butaniravi/JRFCQAI/README.md

# 🚀 JRFCQAI: Dual-Brain Physical AI Fight Computer, Flight Controller & Ground Station all Developed on Arduino UNO Q





**Developer:** Ravi Butani  
**Track:** Robotics & Autonomous UAV  
**Board:** Arduino UNO Q (Qualcomm® Dragonwing™ QRB2210 + STM32U585)  
**Project Status:** Open-Source Software & Hardware Framework  

---

## 📌 Project Overview
<p align="center">
  <br>
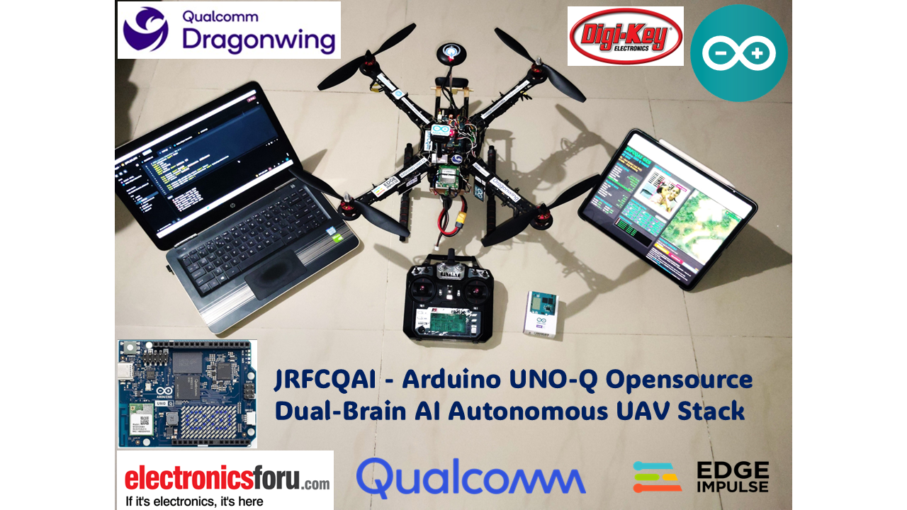
[picture p1: Photos and diagrams/jrfcqai_main.png]
JRFCQAI Project Title Image
  
  <br>
  <em>Figure : JRFCQAI Project Title Image.</em>
</p>
While most projects utilizing the newly launched **Arduino UNO Q** explore basic ground robotics, **JRFCQAI** pushes the platform to its limits: transforming a single alpha-stage UNO Q board into a full-fledged **Flight Computer + Flight Controller** combo for autonomous UAVs.

By leveraging the **Dual-Brain Architecture** of the UNO Q, this framework splits time-critical flight stabilization and high-level Edge AI processing across two dedicated processors on a single PCB:

1. **STM32U585 Microcontroller (MCU):** Runs a deterministic, 250Hz PID loop (Tested up to 500Hz) over Zephyr RTOS for real-time sensor fusion, motor control, and flight stabilization, all flight stabilization routines completes under 1ms and enough time in loop available to execute mission specific user functions.
2. **Qualcomm® Dragonwing™ MPU:** Runs Debian Linux, processing live USB webcam video via YOLO Light Object Detection inside an Arduino App Lab environment. It acts as a local Web Ground Station streaming live telemetry, AI detections, and direct UI controls to any browser on the local Wi-Fi network.

---

## 📹 Media & Video Demonstration
Watch the full build breakdown and flight demo on YouTube:  
<a href="https://www.youtube.com/watch?v=u1FR_EWiBVY&list=PLfxRMvKGemR4" target="_blank">
  YouTube
</a> **[JRFCQAI Video Playlist](https://www.youtube.com/watch?v=u1FR_EWiBVY&list=PLfxRMvKGemR4)**

---
## 🛠️ Hardware Architecture & Sensor Interfaces

<p align="center">
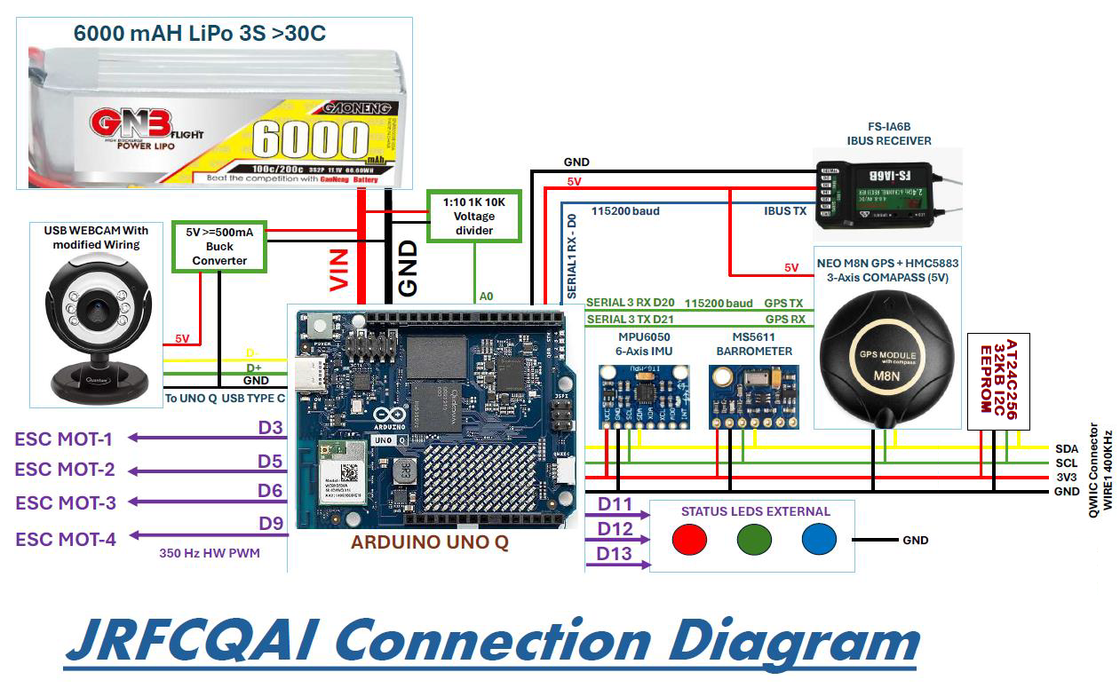
[picture p2: Photos and diagrams/connection_jrfcqai_v1.png]
JRFCQAI Hardware Wiring Diagram
  
  <br>
  <em>Figure 1: Complete wiring layout between Arduino UNO Q, sensors, and ESCs.</em>
  <br>
  <br>
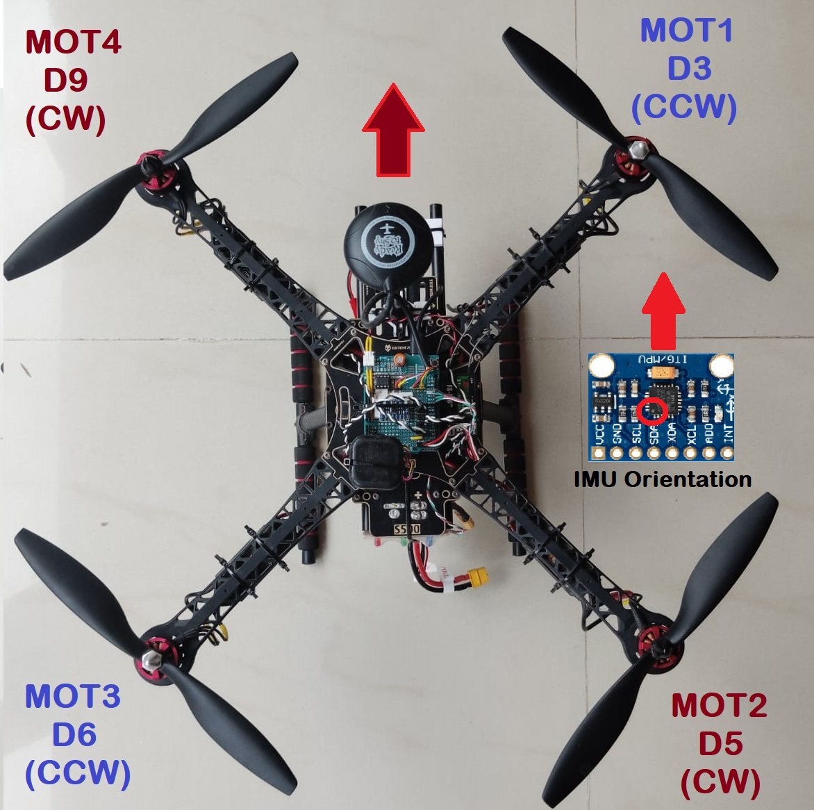
[picture p3: Photos and diagrams/prop_dir_v1.jpg]
JRFCQAI Motor Rotation Direction and UNOQ ESC PIN Mapping
  
  <br>
  <em>Figure 2: Motor Rotation Direction and UNOQ ESC PIN Mapping.</em>
</p>

* **Flight Controller Core:** Arduino UNO Q (Powered directly via VIN with a 100μF 50V filter capacitor from a 3S 6000mAh LiPo).
* **Sensors (I2C1 QWIIC Port @ 400kHz):**
  * **MPU6050:** 6-DOF Gyroscope / Accelerometer
  * **MS5611:** Barometric Pressure / Altitude sensor
  * **HMC5883:** 3-Axis Magnetometer / Compass
  * **AT24C256:** 32KB I2C EEPROM to hold PID and IMU Compass Baro calibration data
* **GPS & Receiver:**
  * **u-blox NEO-M8N GPS:** Connected via UART3 (115200 baud)
  * **Flysky FS-iA6B 10CH Receiver:** iBus interface on UART1 (115200 baud)
* **Actuators & Monitoring:**
  * **4x BLDC ESCs >30 Amp:** Driven at 400Hz on Hardware PWM Pins (`D3`, `D5`, `D6`, `D9`)
  * **Frame:** S500 Quadcopter frame is used in this project for other frame and ESC/BLDC combo please tune default PIDs
  * **Battery Telemetry:** Voltage monitoring on Pin `A0` via a 10K/1K resistor voltage divider
  * **Status Indicators:** RGB Status LEDs on `D11`, `D12`, `D13`
* **Vision System:** Direct USB Webcam connected to the UNO Q Type-C port, powered externally via a dedicated 5V Buck Converter.
---
### 🚨 LED Status Indicators & Blink Codes

**Normal Startup LED Procedure on EXTERNAL RGB LED PANEL**

| Pattern | LED Sequence | State / Description |
| :--- | :--- | :--- |
| Calibration Delay | 🔴&nbsp;&nbsp;&nbsp;🔴&nbsp;&nbsp;&nbsp;🔴&nbsp;&nbsp;&nbsp;🔴&nbsp;&nbsp;&nbsp;🔴&nbsp;&nbsp;&nbsp;🔴&nbsp;&nbsp;&nbsp;🔴 | Initial delay on boot (5 seconds) |
| Gyro Calibration | 🔴🔴 🔴🔴 🔴🔴 🔴🔴 🔴🔴 | Calibrating gyroscope (8 seconds) |
| ARM/DISARM |🔵 LED ON - ARMED &nbsp;⚪ LED OFF - DISARMED  | BLUE LED - ARM Status |
| Flight Mode 1 | 🟢 &nbsp;&nbsp;&nbsp;&nbsp;&nbsp;&nbsp;&nbsp;&nbsp;&nbsp;&nbsp;&nbsp;&nbsp;&nbsp;&nbsp;&nbsp;&nbsp; 🟢 | Auto Level Mode active |
| Flight Mode 2 | 🟢🟢 &nbsp;&nbsp;&nbsp;&nbsp;&nbsp;&nbsp;&nbsp;&nbsp;&nbsp;&nbsp;&nbsp; 🟢🟢 | Altitude Hold Mode active |
| Flight Mode 3 | 🟢🟢🟢 &nbsp;&nbsp;&nbsp;&nbsp;&nbsp;&nbsp; 🟢🟢🟢 | Altitude & GPS Hold Mode active |
---
**GPS LED Indicators (UNO Q - ON BOARD RED LED)**

| Signal State | LED Pattern | Flash Rate |
| :--- | :--- | :--- |
| **No Valid GPS** | *(Off / Solid)* | No Signal |
| **GPS Available** | 🔴 &nbsp;&nbsp;&nbsp;&nbsp;&nbsp;&nbsp;&nbsp;&nbsp;&nbsp;&nbsp;&nbsp;&nbsp;&nbsp;&nbsp; 🔴 &nbsp;&nbsp;&nbsp;&nbsp;&nbsp;&nbsp;&nbsp;&nbsp;&nbsp;&nbsp;&nbsp;&nbsp;&nbsp;&nbsp; 🔴 | Pulse (5Hz) |
| **GPS Lock** | 🔴🔴🔴🔴🔴🔴🔴🔴🔴🔴🔴🔴 | Rapid Blink (25Hz) |
---
### ⚠️ Diagnostic & Error LED Codes

**Errors During Startup**

| Pattern | Error Code / State | Description |
| :--- | :--- | :--- |
| 🔴 | Error 1 | MPU-6050 does not respond |
| 🔴🔴 | Error 2 | HMC5883L does not respond |
| 🔴🔴🔴 | Error 3 | MS5611 does not respond |
| 🔴🔴🔴🔴 | Error 4 | No receiver detected |

---

**Errors After Startup**

| Pattern | Error Code / State | Description |
| :--- | :--- | :--- |
| 🔴 | Error 1 | Battery low |
| 🔴🔴 | Error 2 | Program loop time exceeded |
| 🔴🔴🔴 | Error 3 | ACC calibration angle limit |
| 🔴🔴🔴🔴 | Error 4 | GPS watchdog time exceeded |
| 🔴🔴🔴🔴🔴 | Error 5 | manual_takeoff_throttle not in range |
| 🔴🔴🔴🔴🔴🔴 | Error 6 | No take-off detected |
| 🔴🔴🔴🔴🔴🔴🔴 | Error 7 | Take-off throttle out of range |

---

## 💻 Quick Start & Software Setup

### 1. Flight Controller Firmware (MCU) & Core Patches
1. Open `UNOQ_JRFCQAI_MAIN` in the **Arduino IDE**.
2. Select your **Arduino UNO Q** board target.
3. **Apply Zephyr RTOS Core Patches (Required for 400Hz PWM & GPS Parsing):**

   * **Modify Hardware PWM Frequency:**  
     Open `wiring_analog.cpp` located at:  
     `C:\Users\xxx\AppData\Local\Arduino15\packages\arduino\hardware\zephyr\0.90.0\cores\arduino\wiring_analog.cpp`  
     Locate around line 141 and update the implementation to set a custom period:
     ```cpp
     value = CLAMP(value, 0, maxInput);
     //const uint32_t pulse = map64(value, 0, maxInput, 0, arduino_pwm[idx].period);

     /*
      * A duty ratio determines by the period value defined in dts
      * and the value arguments. So usually the period value sets as 255.
      */
     //(void)pwm_set_pulse_dt(&arduino_pwm[idx], pulse);
     const uint32_t custom_period = 2500000UL;
     const uint32_t pulse = map64(value, 0, maxInput, 0, custom_period);
     (void)pwm_set(arduino_pwm[idx].dev, arduino_pwm[idx].channel, custom_period, pulse, arduino_pwm[idx].flags);
     ```

   * **Expand UART Receive Buffer Size:**  
     Open `ZephyrSerial.h` located at:  
     `C:\Users\xxx\AppData\Local\Arduino15\packages\arduino\hardware\zephyr\0.90.0\cores\arduino\ZephyrSerial.h`  
     Locate line 54 inside `ZephyrSerialBuffer` and set the buffer array size to 512 bytes:
     ```cpp
     class ZephyrSerial : public HardwareSerial {
     public:
         template <int SZ> class ZephyrSerialBuffer {
             friend arduino::ZephyrSerial;
             struct ring_buf ringbuf;
             uint8_t buffer[512]; // ---> Hardcode SZ to 512
             struct k_sem sem;
     ```

4. Flash the sketch to the board to initialize the STM32U585 real-time flight loop.

### 2. Ground Station & AI System (MPU)
1. Launch **Arduino AppLab**.
2. Import the `JRFC_QAI_GCS` Python project.
3. Run the application to start the web ground station and AI detection engine.

> **💡 Hardware Note (Camera Troubleshooting):**  
> If your USB webcam does not initialize upon booting the Ground Station you need to enable USB Host mode on UNO Q, open the **Arduino UNO Q Shell** in AppLab and execute the following commands to force USB Host Mode:
> ```bash
> sudo -i
> echo host > /sys/kernel/debug/usb/4e00000.usb/mode
> ```

---

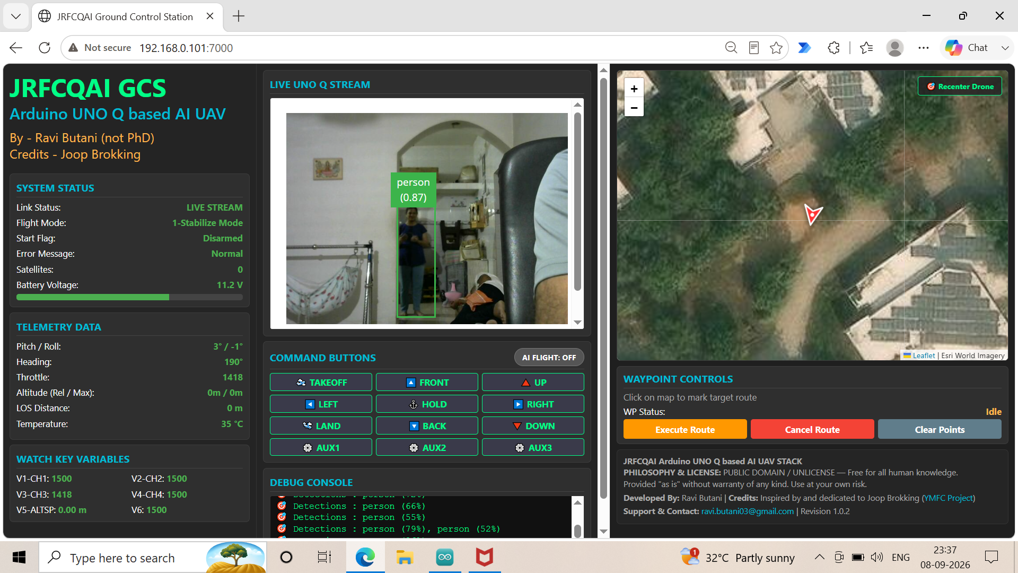
[picture p4: Photos and diagrams/Screenshot (406).png]
JRFCQAI GCS Webpage hosted by UNO Q with Live AI Video stream
  
  <em>Figure 3: JRFCQAI GCS Webpage hosted by UNO Q with Live AI Video stream.</em>
  <br>

---

### 💡 Key Engineering Challenges & Technical Breakthroughs

1. **Low-Weight, Cost-Effective Power Routing:** Solved the USB Host power limitation on boot without using heavy, expensive USB-C Power Delivery hubs by routing webcam power to a lightweight 5V 500mA Buck Converter and triggering USB Host mode via startup scripts.
2. **Zephyr RTOS Kernel Hacks for PWM:** Overcame default 500Hz PWM constraints by hacking the underlying Zephyr RTOS layer to modify default output down to 400Hz, enabling precise ESC and servo synchronization.
3. **Serial Buffer Expansion for GPS Data:** Prevented packet loss on the standard 64-byte UART buffer by patching Zephyr RTOS to allocate a 512-byte UART RX buffer for loss-free u-blox GPS parsing.
4. **Optimized 250Hz PID Execution Loop:** Implemented `k_yield()` and `k_sleepus()` inside the main flight loop to guarantee a fixed 4ms (250Hz) execution cycle with ~3ms of spare processing headroom per loop.
5. **Zero-Blocking RPC Bridge Communication:** Replaced blocking `bridge.call()` calls (which introduce 5–7ms delays in flight loop timing) with asynchronous `bridge.notify()` fire-and-forget RPC calls for non-blocking telemetry sync between the STM32 flight core and Qualcomm Linux host.
6. **Core Architecture Migration:** Ported and expanded the YMFC-32 Autonomous framework from legacy STM32F103 bare-metal registers to the modern STM32U5 platform running Zephyr RTOS, replacing PPM-SUM receiver input with native iBus support.

---

## 📊 Current Capabilities & Roadmap

- [x] Auto-Level Flight Mode *(Tested)*
- [x] Altitude Hold Mode *(Tested)*
- [x] GPS Position Hold Mode *(Tested)*
- [x] Automatic Takeoff & Landing *(Tested)*
- [x] Failsafe System *(RTH on GPS signal / Slow descent altitude hold on signal loss - Tested)*
- [x] Real-Time YOLO Object Detection AI *(Tested)*
- [x] Browser-Based Ground Station & Live Video Feed *(Tested)*
- [x] Return to Home (RTH) Execution *(Tested)*
- [x] Autonomous Waypoint Navigation *(Tested fine tuning under progress)*
- [x] Autonomous Flight and task execution based on Edge Impulse AI brick execution results *(Tested)*
- [ ] Design and fabricate custom PCB compatible with **Arduino UNO Q** and **Arduino VENTUNO Q** *(Under progress)*
- [ ] Add SIMCOM A76XX 4G LTE support via USB RNDIS/CDC ECM for GCS Dashboard and live streaming *(RNDIS driver not precompiled with UNO Q kernel so focusing on CDC ECM - under progress)*
- [ ] Framework expansion for Hexcopter & Fixed-Wing platforms *(Under progress)*

---

## 🌐 Open-Source Impact & Community Contribution

JRFCQAI is released as a fully open-source framework—including hardware schematics, Zephyr patch scripts, Arduino sketches, and Python App Lab code—to democratize advanced edge-AI robotics on the UNO Q platform. The goal is to provide the global maker community with a tested blueprint for complex, real-time autonomous systems without relying on high-cost commercial flight controllers.

---

## 🙏 Credits & Acknowledgments

Special thanks and full attribution to **[Joop Broking](https://www.youtube.com/playlist?list=PL0K4VDicBzshwCpUHzIB6hOLQVkDFHbxC)**, creator of the original **[YMFC-32 Autonomous Flight Controller](http://www.brokking.net/ymfc-32_auto_main.html)**. His pioneering open-source work provided the fundamental mathematical foundation for the flight stabilization algorithms ported into this project.

---

## ⚠️ Disclaimer

<font color="#D9381E">

*This is an **experimental, open-source educational project** developed strictly for testing and research purposes. **Unmanned Aerial Vehicles (UAVs) can cause severe physical injury or property damage if mishandled.** This framework is provided **"AS IS"**, without warranty or guarantee of any kind. **Operate experimental hardware entirely at your own risk**, follow all local aviation regulations, and adhere to strict safety protocols during testing.*

</font>
