butaniravi/JRFCQAI/Photos and diagrams/connection_jrfcqai.png

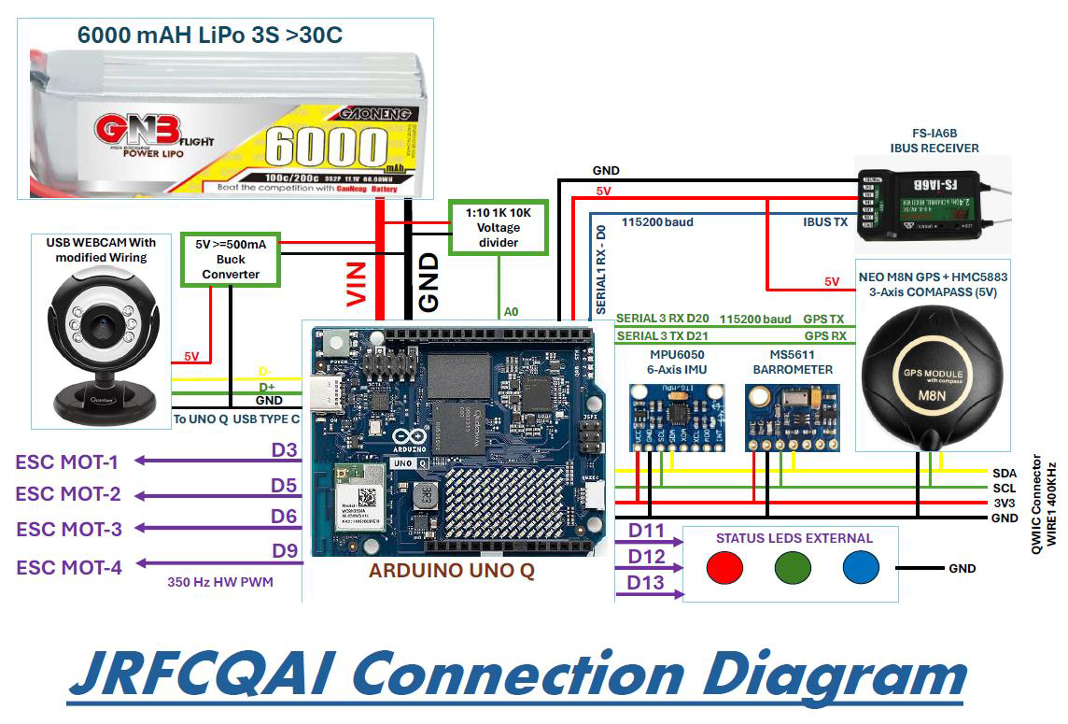
Photos and diagrams/connection_jrfcqai.png
