butaniravi/JRFCQAI/Photos and diagrams/GCS.png

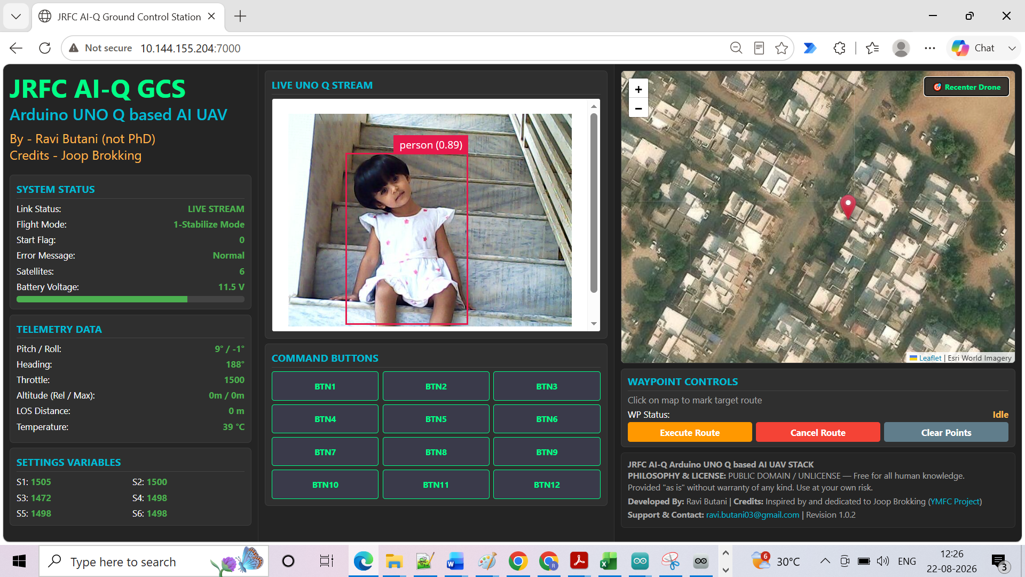
Photos and diagrams/GCS.png
