butaniravi/JRFCQAI/Photos and diagrams/WhatsApp Image 2026-08-22 at 10.00.45 AM.jpeg

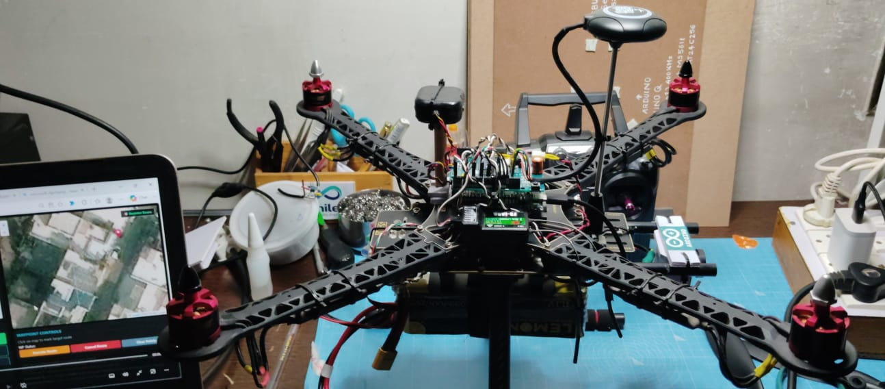
Photos and diagrams/WhatsApp Image 2026-08-22 at 10.00.45 AM.jpeg
