butaniravi/JRFCQAI/Photos and diagrams/WhatsApp Image 2026-08-22 at 10.01.03 AM (1).jpeg

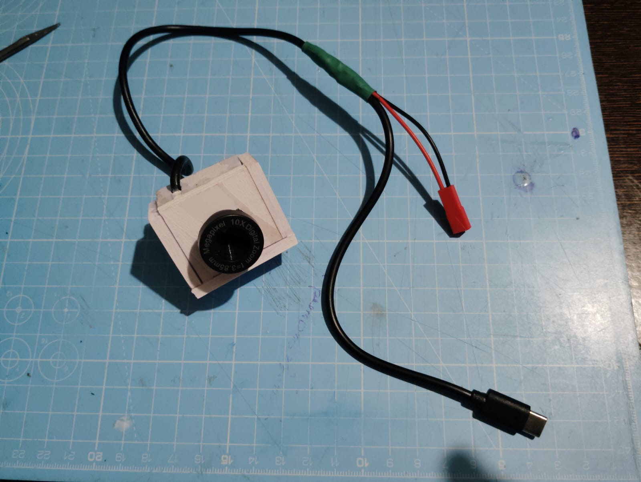
Photos and diagrams/WhatsApp Image 2026-08-22 at 10.01.03 AM (1).jpeg
