butaniravi/JRFCQAI/Photos and diagrams/WhatsApp Image 2026-08-22 at 10.01.11 AM.jpeg

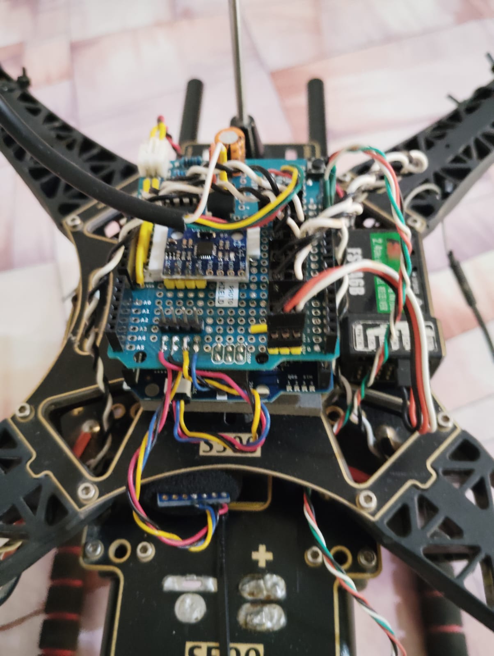
Photos and diagrams/WhatsApp Image 2026-08-22 at 10.01.11 AM.jpeg
