butaniravi/JRFCQAI/Photos and diagrams/WhatsApp Image 2026-08-22 at 10.01.16 AM (2).jpeg

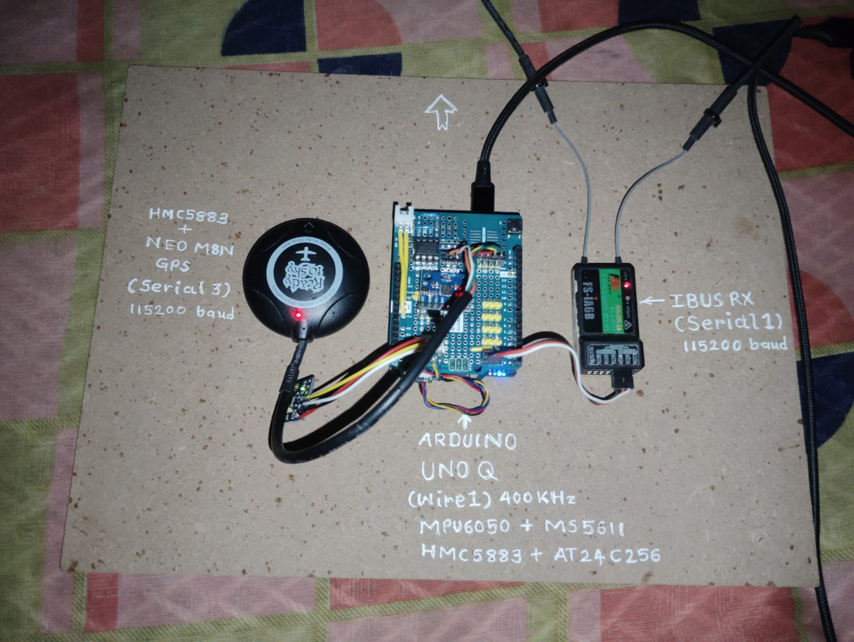
Photos and diagrams/WhatsApp Image 2026-08-22 at 10.01.16 AM (2).jpeg
