butaniravi/JRFCQAI/Photos and diagrams/WhatsApp Image 2026-08-22 at 10.01.19 AM (3).jpeg

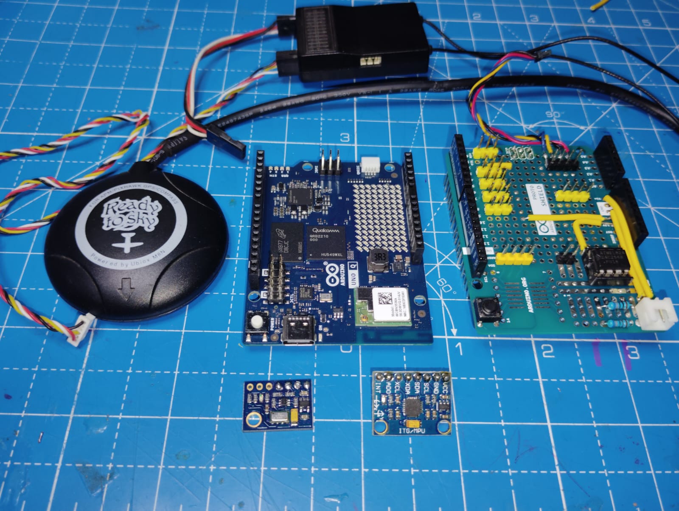
Photos and diagrams/WhatsApp Image 2026-08-22 at 10.01.19 AM (3).jpeg
