butaniravi/JRFCQAI/Photos and diagrams/WhatsApp Image 2026-08-22 at 12.37.32 PM.jpeg

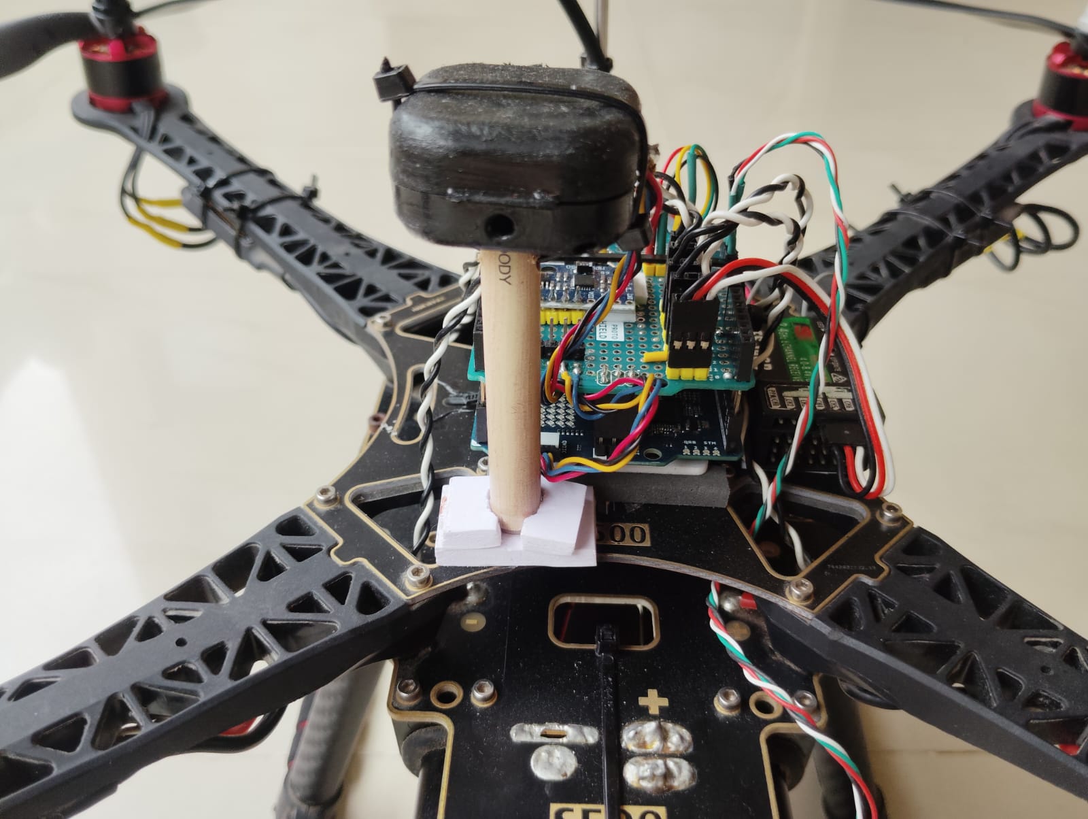
Photos and diagrams/WhatsApp Image 2026-08-22 at 12.37.32 PM.jpeg
