butaniravi/JRFCQAI/Photos and diagrams/WhatsApp Image 2026-08-22 at 12.37.36 PM (1).jpeg

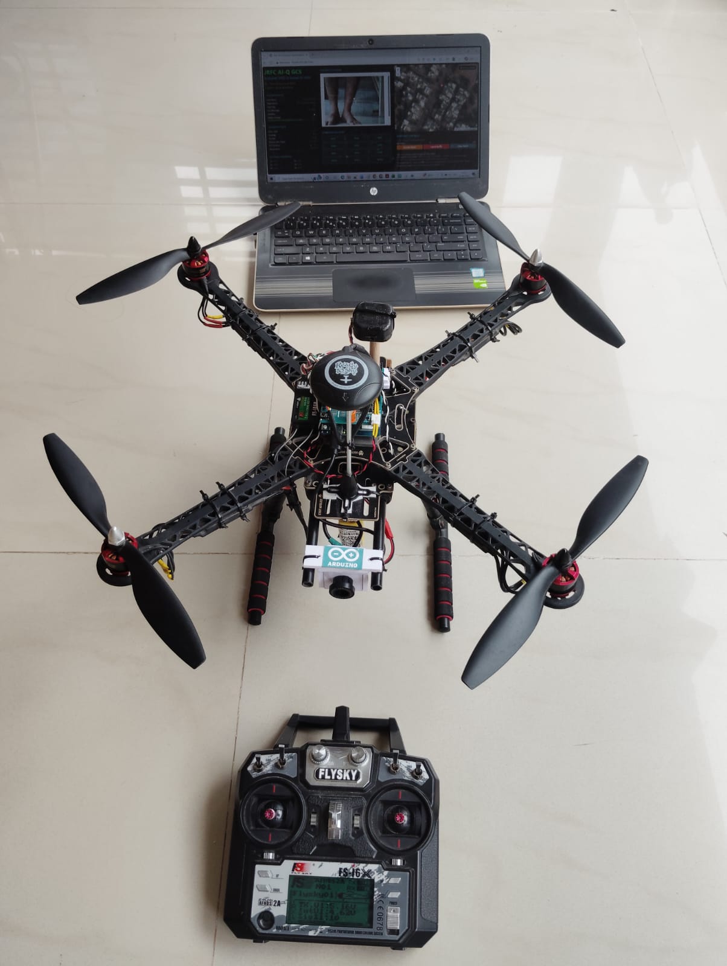
Photos and diagrams/WhatsApp Image 2026-08-22 at 12.37.36 PM (1).jpeg
