butaniravi/JRFCQAI/UNOQ_JRFCQAI_MAIN/vertical_acceleration_calculations.ino

///////////////////////////////////////////////////////////////////////////////////////////////////////////////////////////////////////
//In this part the vertical acceleration is calculated over a longer period via a rotating memory.
///////////////////////////////////////////////////////////////////////////////////////////////////////////////////////////////////////
void vertical_acceleration_calculations(void) {
  acc_z_average_short_rotating_mem_location++;
  if (acc_z_average_short_rotating_mem_location == 25)acc_z_average_short_rotating_mem_location = 0;

  acc_z_average_short_total -= acc_z_average_short[acc_z_average_short_rotating_mem_location];
  acc_z_average_short[acc_z_average_short_rotating_mem_location] = acc_total_vector;
  acc_z_average_short_total += acc_z_average_short[acc_z_average_short_rotating_mem_location];

  if (acc_z_average_short_rotating_mem_location == 0) {
    acc_z_average_long_rotating_mem_location++;

    if (acc_z_average_long_rotating_mem_location == 50)acc_z_average_long_rotating_mem_location = 0;

    acc_z_average_long_total -= acc_z_average_long[acc_z_average_long_rotating_mem_location];
    acc_z_average_long[acc_z_average_long_rotating_mem_location] = acc_z_average_short_total / 25;
    acc_z_average_long_total += acc_z_average_long[acc_z_average_long_rotating_mem_location];
  }
  acc_z_average_total = acc_z_average_long_total / 50;


  acc_alt_integrated += acc_total_vector - acc_z_average_total;
  if (acc_total_vector - acc_z_average_total < 400 || acc_total_vector - acc_z_average_total > 400) {
    if (acc_z_average_short_total / 25 - acc_z_average_total < 500 && acc_z_average_short_total / 25 - acc_z_average_total > -500)
      if (acc_alt_integrated > 200)acc_alt_integrated -= 200;
      else if (acc_alt_integrated < -200)acc_alt_integrated += 200;
  }
}
