butaniravi/JRFCQAI/(commit log)

2026-08-22 Fix capacitor value in hardware architecture section
2026-08-24 new version with tested GPS Hold and Waypoint
    new version with tested GPS Hold and Waypoint travel and bidirectional RPC Bridge, Solid stability and ready for AI Pipeline for Autonomous Flying
    [Barometer.ino, Eeprom.ino, LED_control.ino, Soft_serial_handling.ino, UNOQ_JRFCQAI_MAIN.ino, calculate_pid.ino, calibration.ino, change_settings.ino]
2026-08-24 Enhance README with firmware setup details must needed to do
    Updated the README to include core patches for Zephyr RTOS and expanded instructions for modifying PWM frequency and UART RX buffer size.
2026-08-24 Fix file path in README for ZephyrSerial.h
    Updated file path in README for UART Receive Buffer Size.
2026-08-25 Fix image URL and capacitor notation in README
    Updated image source URL and corrected capacitor notation.
2026-08-25 Remove duplicate wiring diagram from README
    Removed duplicate wiring diagram image and caption.
2026-08-25 Replace wiring diagram and update figure captions
    Updated wiring diagram and figure descriptions in README.
2026-08-25 Update image format for motor rotation diagram
2026-08-25 Enhance README with LED status indicators
    Added LED status indicators and blink codes section to README.
2026-08-25 Fix LED sequence formatting in README
2026-08-25 Fix LED sequence formatting in README
    Updated LED sequence formatting for better readability.
2026-08-25 Clarify LED startup procedure and formatting
    Updated LED status indicators section to clarify the procedure and added HTML entities for spacing.
2026-08-25 Add diagnostic & error LED codes to README
    Added diagnostic and error LED codes section to README.
2026-08-25 Include GPS LED indicators in README
    Added GPS LED indicators section to README.
2026-08-25 Update README with GPS LED indicators
    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
2026-08-25 Change LED indicators for GPS states
    Updated LED patterns for GPS states in the README.
2026-08-25 Add frame details and PID tuning note
    Added information about the S500 Quadcopter frame and tuning PIDs.
2026-08-25 Update ESC description in README.md
2026-08-26 Enhance README with MCU PID loop details and EEPROM info
    Updated the README to reflect enhancements in the STM32U585 MCU's PID loop performance and added information about the AT24C256 EEPROM for calibration data.
2026-08-26 Update hardware wiring diagram image in README
2026-08-26 Update README with ARM/DISARM LED status
    Added ARM/DISARM status to LED sequence table.
2026-08-26 Fix formatting in ARM/DISARM section of README
2026-08-26 imu orientation marking added
2026-08-26 Updated documentation
    with EEPROM and IMU Prop Orientation details added
2026-08-30 Update README with new wiring_analog.cpp path
    Updated the path for wiring_analog.cpp to version 0.90.0.
2026-09-12 Update PWM frequency from 350Hz to 400Hz in README
2026-09-12 Fix badge link for Robotics track in README
2026-09-12 Fix badge link for Robotics track
    Updated badge link for Robotics track in README.
